finite-colin-machine/ME-507-GS425-Dashboard/docs/dash_installed.jpg

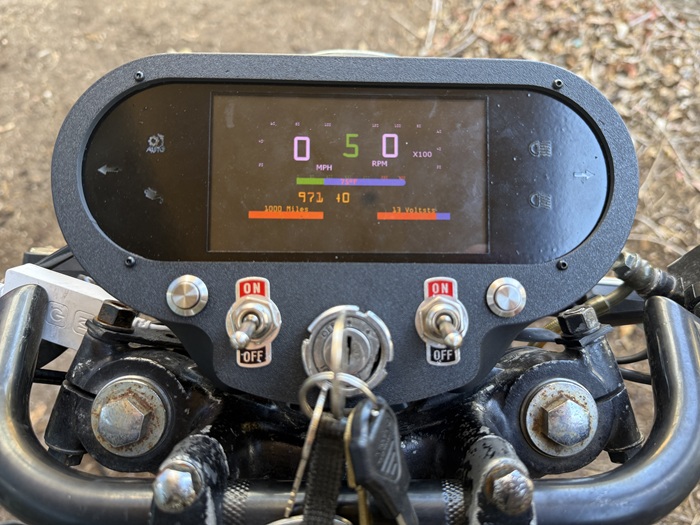
docs/dash_installed.jpg
