finite-colin-machine/ME-507-GS425-Dashboard/docs/dash_front.png

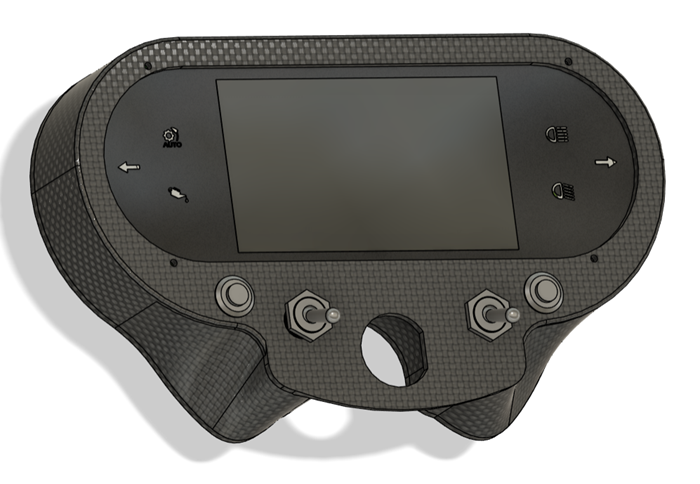
docs/dash_front.png
