finite-colin-machine/ME-507-GS425-Dashboard/docs/case_open.jpg

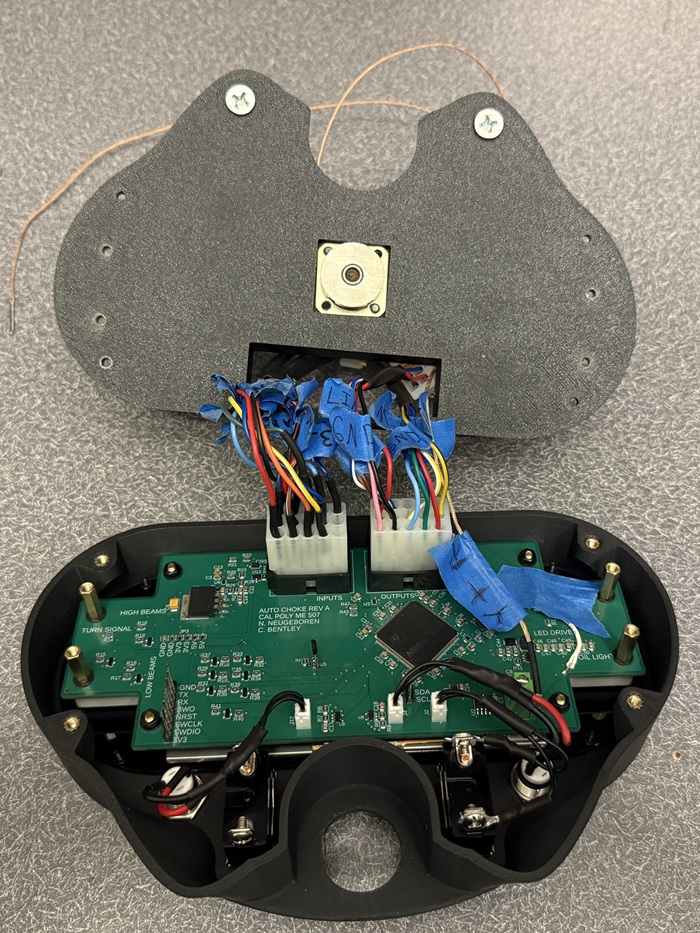
docs/case_open.jpg
