finite-colin-machine/ME-507-GS425-Dashboard/docs/choke_control_back.jpg

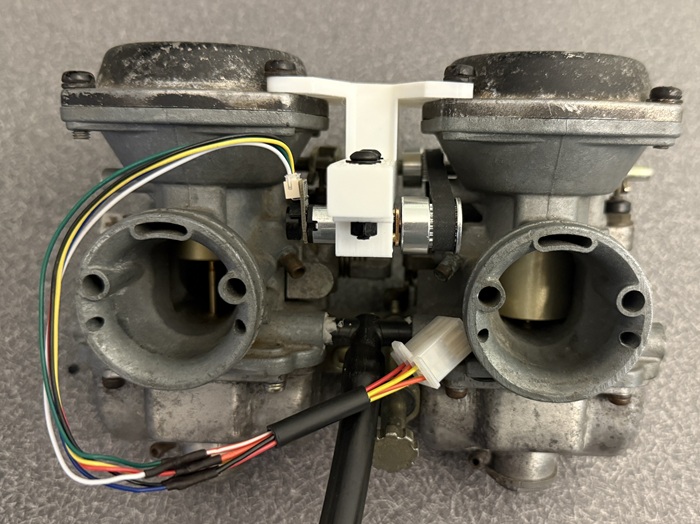
docs/choke_control_back.jpg
