finite-colin-machine/ME-507-GS425-Dashboard/docs/CIJV7845.JPG

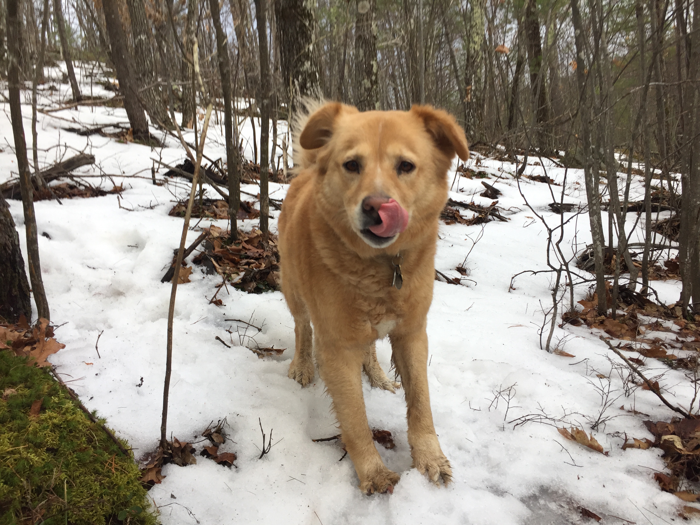
docs/CIJV7845.JPG
