finite-colin-machine/ME-507-GS425-Dashboard/docs/dash_back.png

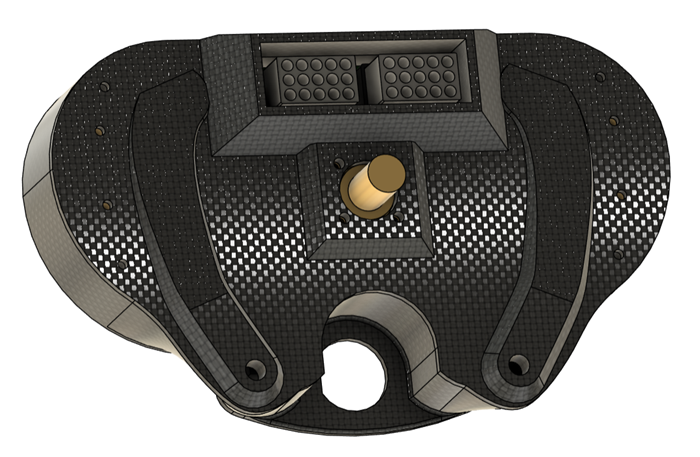
docs/dash_back.png
