finite-colin-machine/ME-507-GS425-Dashboard/docs/display.png

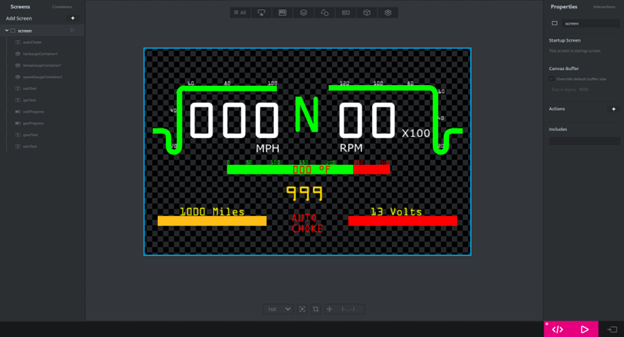
docs/display.png
