finite-colin-machine/ME-507-GS425-Dashboard/docs/DMA2D.png

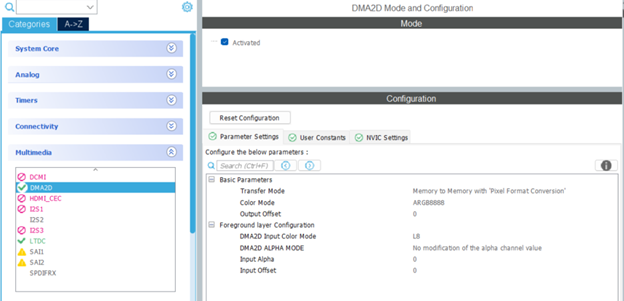
docs/DMA2D.png
