finite-colin-machine/ME-507-GS425-Dashboard/docs/electronics.png

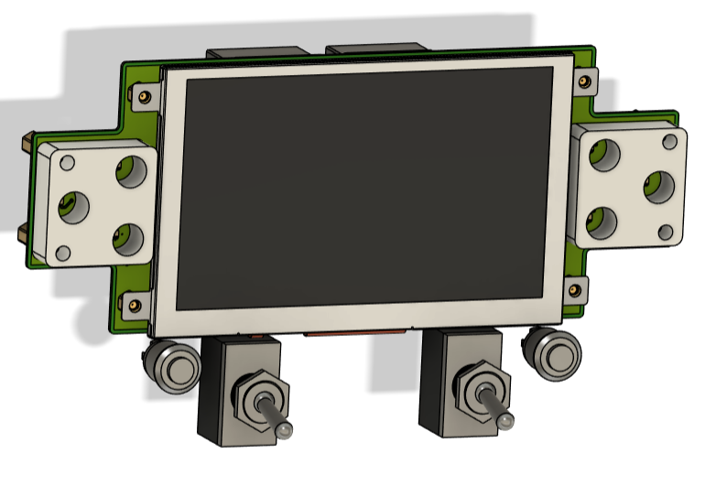
docs/electronics.png
