finite-colin-machine/ME-507-GS425-Dashboard/docs/LTDC.png

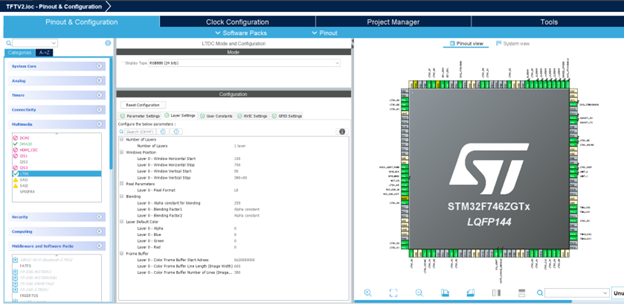
docs/LTDC.png
