finite-colin-machine/ME-507-GS425-Dashboard/docs/PCB.png

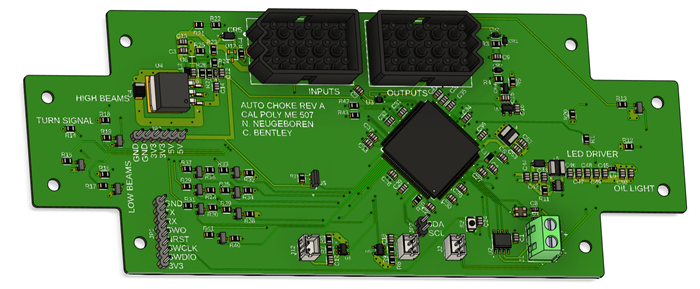
docs/PCB.png
