finite-colin-machine/ME-507-GS425-Dashboard/docs/task1.png

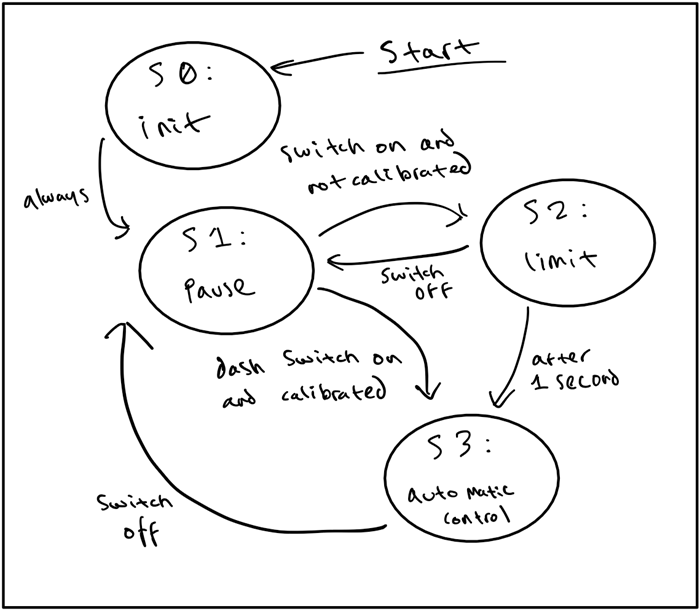
docs/task1.png
