finite-colin-machine/ME-507-GS425-Dashboard/docs/task2.png

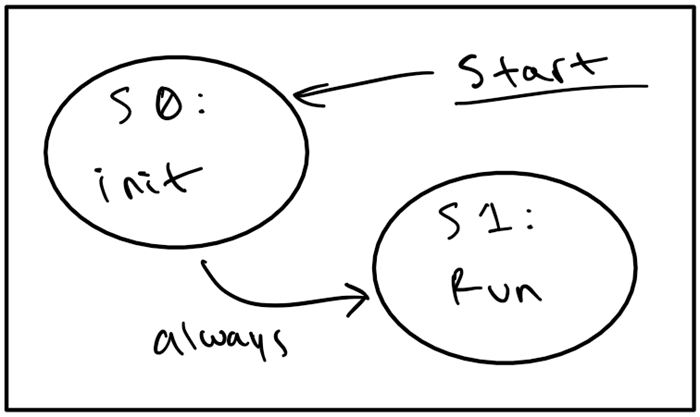
docs/task2.png
