finite-colin-machine/ME-507-GS425-Dashboard/hardware/Dashboard_BOM.xlsx

Description | Qty and/or Designator | Vendor | Vendor P/N
DC Motor with Encoder | 1 | Adafruit | 4641
Thermocouple | 1 | Adafruit | 3245
TFT Display | 1 | Riverdi | SM-RVT50HQTFWN00
40 Pin Connector | 1 | Riverdi | ZIF0540UH
Hall Effect Sensor | 1 | Digikey | 480-5925-ND
SWD Header | 1 | Digikey | 732-5321-ND
UI Switch | 2 | Digikey | CWI285-ND
UI Button | 2 | Digikey | 679-2452-ND
2 Pin Connector For Buttons and Switches | 3 | Digikey | 455-1704-ND
15 Pin Connector | 2 | Digikey | WM22700-ND
Limit Switches | 2 | Digikey | 39-SS-5GL2-ND
2 Position Screw Terminal | 1 | Digikey | A98076-ND
Red SMD LED | 1 | Digikey | 160-1427-1-ND
Blue SMD LED | 2 | Digikey | 160-1645-1-ND
Green SMD LED | 2 | Digikey | 160-1887-1-ND
Yellow SMD LED | 1 | Digikey | 160-1428-1-ND
100 nF | C1 C2 C10 C13 C16 C17 C18 C24 C25 C26 C27 C28 C29 C30 C31 C32 C33 C34 C35 C41 C43 C44 C45 C46 C51 C52 | JLCPCB | C28233
10 kohm | R2 R5 R6 R8 R10 R26 R42 R43 | JLCPCB | C17414
10 nF | C9 C47 C48 C49 C50 C53 | JLCPCB | C1710
1.5 ohm | R11 | JLCPCB | C17392
100 uF | C4 | JLCPCB | C7196
22 ohm | R12 R14 R16 R18 R28 R30 R32 R34 R36 R38 R40 | JLCPCB | C17561
5.6 kohm | R13 R15 R17 R19 R29 R31 R33 R35 R37 R39 R41 | JLCPCB | C4382
100 kohm | R44 | JLCPCB | C149504
10 pF | C11 | JLCPCB | C1634
10 uF | C3 C14 | JLCPCB | C15850
12 kohm | R21 | JLCPCB | C17444
15 pF | C7 C8 | JLCPCB | C1644
1 kohm | R3 | JLCPCB | C17513
1N4148 | CR1 CR2 CR3 | JLCPCB | C2128
2.2 uF | C5 C37 C39 | JLCPCB | C19110
220 kohm | R23 R27 | JLCPCB | C17556
22 uF | C12 | JLCPCB | C45783
3.3 kohm | R4 R7 R9 R22 | JLCPCB | C26010
30 kohm | R24 R25 | JLCPCB | C17621
4.7 uF | C6 C36 C42 | JLCPCB | C1779
4.7uH | L1 L2 | JLCPCB | C86090
47nF | C15 | JLCPCB | C53134
62 Ohm | R1 R20 | JLCPCB | C17784
S8050 | Q1 Q2 Q3 Q4 Q5 Q6 Q7 Q8 Q9 Q10 Q11 | JLCPCB | C2150
SN74LVC1G14DBVRDBV5 | U7 U8 U9 | JLCPCB | C7835
AO3401ASOT-23-3L_AOS | U12 | JLCPCB | C15127
B3U-X000B3U | S2 | JLCPCB | C231329
BLM18SG700TN1D | L6 | JLCPCB | C113031
SWPA4030S100MT | L5 L7 | JLCPCB | C38117
X322525MOB4SISMT | XTAL1 | JLCPCB | C9006
STM32F746ZGT6LQFP-144_STM | NC | JLCPCB | C90750
DIO5661ST6 | U10 | JLCPCB | C324576
DRV8210DRLRSOT_210DRLR_TEX | U3 | JLCPCB | C3681297
MAX6675ISA_T | U2 | JLCPCB | C16030
LBZT52C8V2T1G | CR5 | JLCPCB | C12747
LM1085ISX-3.3/NOPBKTT3 | U4 | JLCPCB | C19545
MCR100 | CR4 | JLCPCB | C5184415
SS26FL | U11 | JLCPCB | C183996
TPS564257DRLR_TEX | U6 | JLCPCB | C19272233
