finite-colin-machine/ME-507-GS425-Dashboard/hardware/Auto_Choke_CAD.STEP

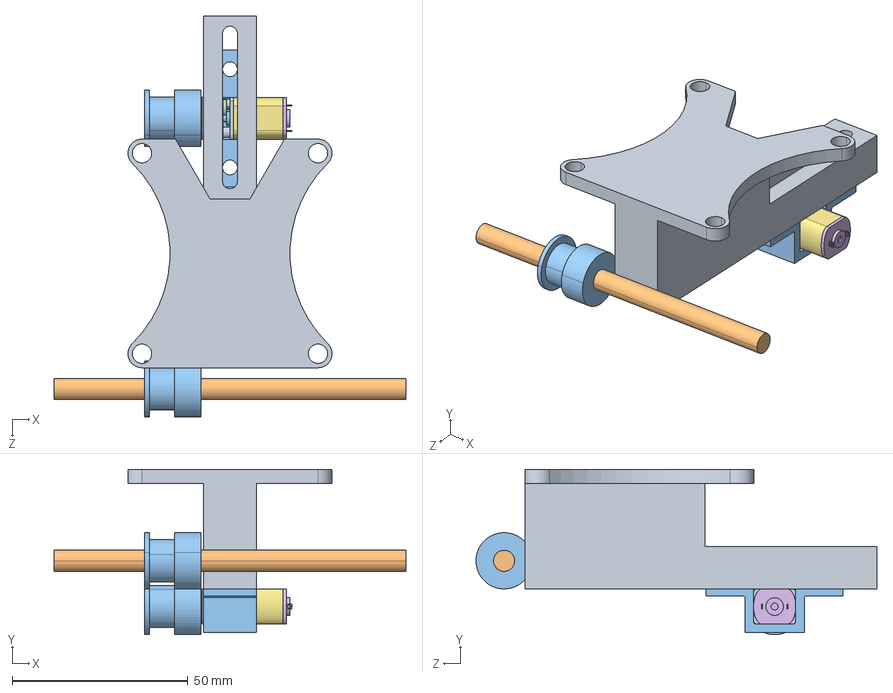
[picture p15: CAD file, 2025-06-11]
hardware/Auto_Choke_CAD.STEP
100.0 x 47.0 x 114.0 mm
carb_plate
carb_shaft
pulleygear x 2
N20 Motor
motor_mount
