finite-colin-machine/ME-507-GS425-Dashboard/hardware/GS425_Dashboard_Wiring.pdf

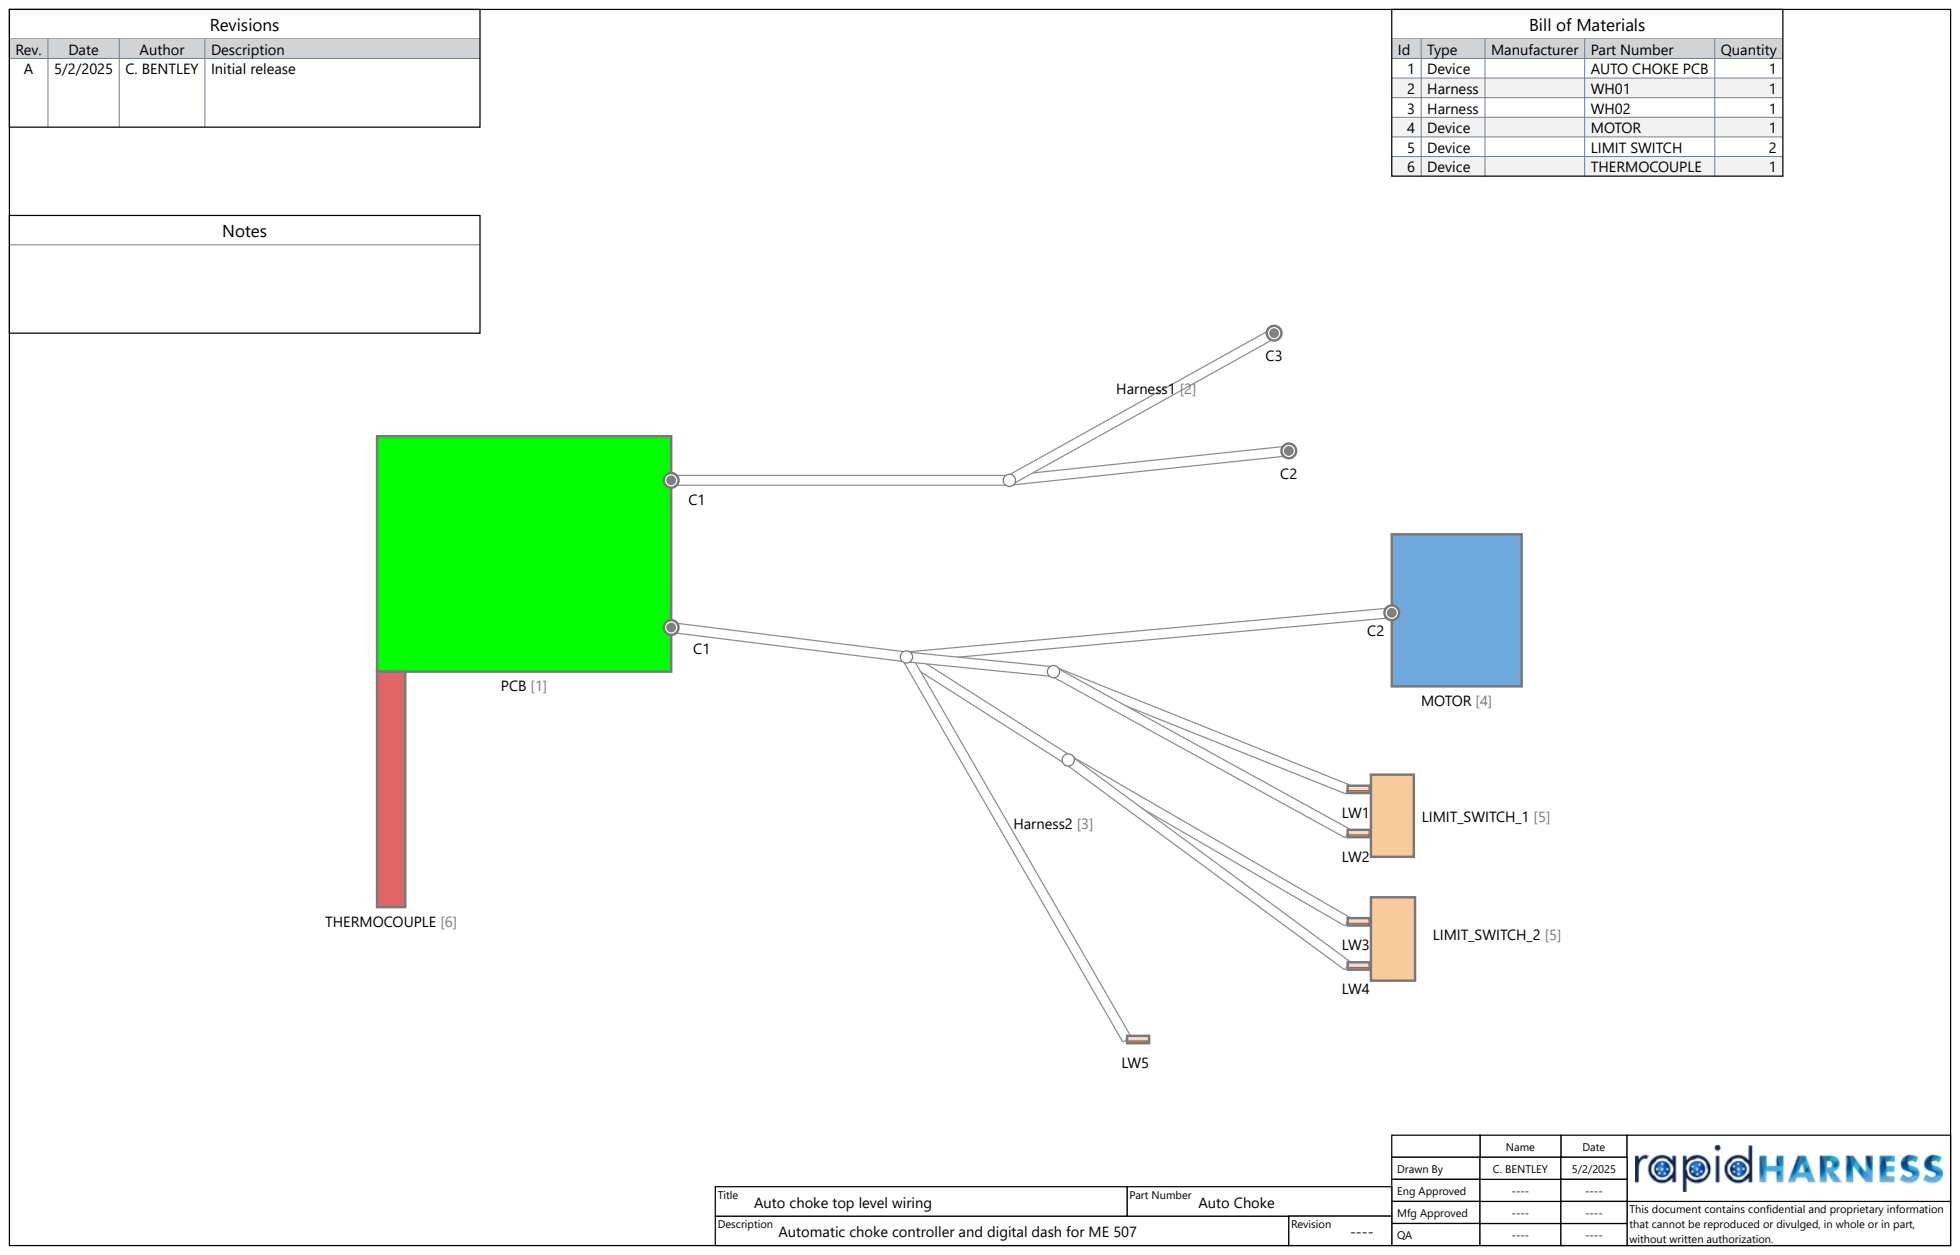
[picture p16: page 1]
Description; Name; Date; Drawn By; Eng Approved; Mfg Approved; Part Number; Revision; Auto Choke; Automatic choke controller and digital dash for ME 507; C. BENTLEY; Type; Manufacturer; Quantity; Device; AUTO CHOKE PCB; Harness; MOTOR; LIMIT SWITCH; THERMOCOUPLE; Notes; Revisions; Rev.; Author; Initial release; PCB [1]; MOTOR [4]; LIMIT_SWITCH_1 [5]; LIMIT_SWITCH_2 [5]; THERMOCOUPLE [6]; Harness1 [2]; Harness2 [3]

Bill of Materials

Title
Auto choke top level wiring

This document contains confidential and proprietary information
that cannot be reproduced or divulged, in whole or in part,
without written authorization.

Rev. | Date | Author | Description
A | 5/2/2025 | C. BENTLEY | Initial release
Revisions 1 of 1 | Page 2 of 7

Title:

Part Number: | Auto Choke
Description: | Automatic choke controller and digital dash for ME 507

Flag | Quantity | Note
Notes 1 of 1 | Page 3 of 7
| Auto Choke
Description: | Automatic choke controller and digital dash for ME 507

Id | Type | Manufacturer | Part Number | Description | Quantity | Usage
1 | Device | AUTO CHOKE PCB | 1 | PCB
2 | Harness | WH01 | Connects PCB to existing bike connections | 1 | Harness1
3 | Harness | WH02 | Connects PCB to new devices on bike | 1 | Harness2
4 | Device | MOTOR | 1 | MOTOR
5 | Device | LIMIT SWITCH | 2 | LIMIT_SWITCH_1, LIMIT_SWITCH_2
6 | Device | THERMOCOUPLE | 1 | THERMOCOUPLE
Bill of Materials 1 of 1 | Page 4 of 7

Description:

Auto Choke

Automatic choke controller and digital dash for ME 507

# | Type | Manufacturer | Part Number | Description | Quantity

2 | Connector | MOLEX | 03091157 | 2.36mm Diameter Standard .093" Pin and Socket Receptacle Housing, 15 Circuits, 3 Rows, without Mounting Ears, with Lock Ramps | 2
6 | Connector | MOLEX | 0510210600 | CONN RCPT HSG 6POS 1.25MM | 1
3 | Connector | Ruibapa | P-029-06 | 2.8mm automotive wire connector | 1
4 | Connector | Ruibapa | P-029-08 | 2.8mm automotive wire connector | 1
1 | Device | | AUTO CHOKE PCB | | 1
8 | Device | | LIMIT SWITCH | | 2
7 | Device | | MOTOR | | 1
9 | Device | | THERMOCOUPLE | | 1
5 | Wire | | | | 0 in
Aggregate Bom 1 of 1 | Page 5 of 7
| Auto Choke
Description: | Automatic choke controller and digital dash for ME 507

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
al 1 | Harness1 Harness1 | C1.1 C2.1 2 | Harness1 Harness1 | C1.2 C2.2 3 | Harness1 Harness1 | C1.3 C2.3 4 | Harness1 Harness1 | C1.4 C2.4 5 | Harness1 Harness1 | C1.5 C2.5 6 | Harness1 Harness1 | C1.6 C2.6 7 | Harness1 Harness1 | C1.7 C3.1 8 | Harness1 Harness1 | C1.8 C3.2 9 | Harness1 Harness1 | C1.9 C3.3
1 0 | H a r n e s s 1 H a r n e s s 1 | C 1 . 1 0 C 3 . 4
1 1 | H a r n e s s 1 H a r n e s s 1 | C 1 . 1 1 C 3 . 5
1 2 | H a r n e s s 1 H a r n e s s 1 | C 1 . 1 2 C 3 . 6
1 3 | H a r n e s s 1 H a r n e s s 1 | C 1 . 1 3 C 3 . 7
1 4 | H a r n e s s 2 H a r n e s s 2 | C 1 . 1 C 2 . 1
1 5 | H a r n e s s 2 H a r n e s s 2 | C 1 . 2 C 2 . 2
1 6 | H a r n e s s 2 H a r n e s s 2 | C 1 . 3 C 2 . 3
1 7 | H a r n e s s 2 H a r n e s s 2 | C 1 . 4 C 2 . 4
1 8 | H a r n e s s 2 H a r n e s s 2 | C 1 . 5 C 2 . 5
1 9 | H a r n e s s 2 H a r n e s s 2 | C 1 . 6 C 2 . 6
2 0 | H a r n e s s 2 H a r n e s s 2 | C 1 . 7 LW 1
2 1 | H a r n e s s 2 | C 1 . 8

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

# | Subsystem | Device / Harness | Endpoint | Signal

| | Harness2 | LW2
22 | | Harness2 Harness2 | C1.9 LW3
23 | | Harness2 Harness2 | C1.10 LW4
24 | | Harness2 Harness2 | C1.11 LW5
Nets 2 of 2 | Page 7 of 7
| Auto Choke
Description: | Automatic choke controller and digital dash for ME 507

Description

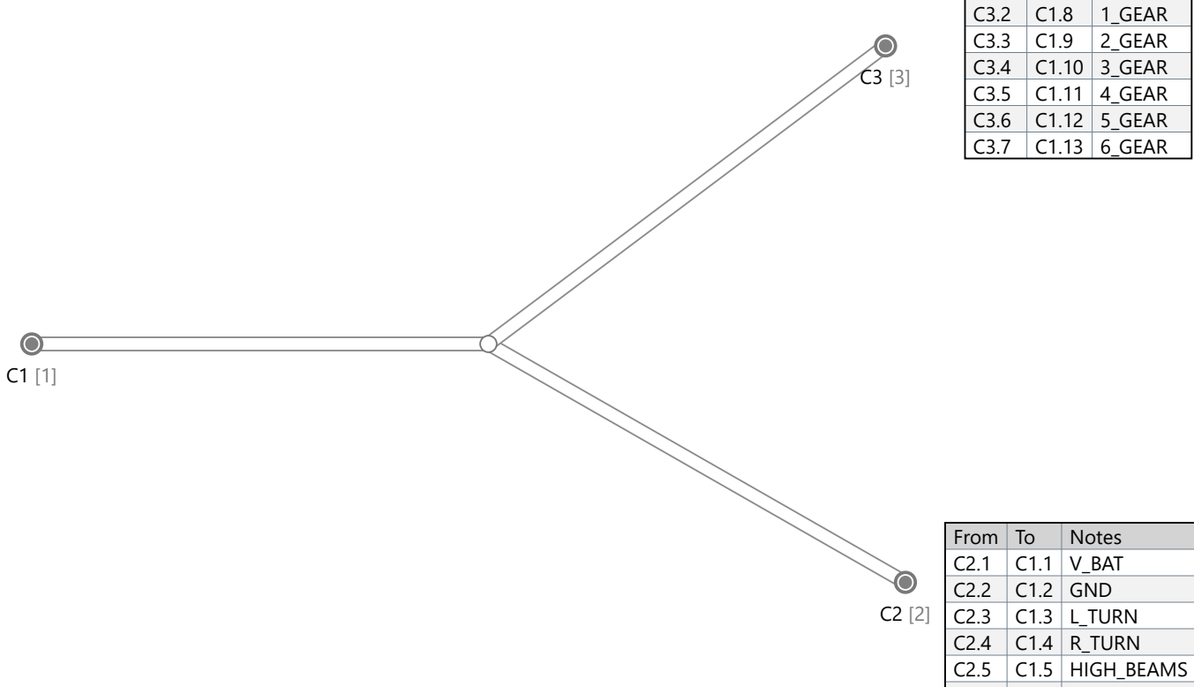
[picture p17: figure]
From; Notes; V_BAT; GND; L_TURN; R_TURN; HIGH_BEAMS; 1_GEAR; 2_GEAR; 3_GEAR; 4_GEAR; 5_GEAR; 6_GEAR

Name | Date

Drawn By

Eng Approved

Mfg Approved

QA

This document contains confidential and proprietary information that cannot be reproduced or divulged, in whole or in part, without written authorization.

Part Number

Revision

Title | WH01
Connects PCB to existing bike connections | ----
C. BENTLEY | 5/2/2025

Existing Harness

Bill of Materials

Id | Type | Manufacturer | Part Number | Quantity
1 | Connector | MOLEX | 03091157 | 1
2 | Connector | Ruibapa | P-029-06 | 1
3 | Connector | Ruibapa | P-029-08 | 1
4 | Wire | | | 0 in

Notes

Revisions

Rev. | Date | Author | Description
A | 5/2/2025 | C. BENTLEY | Initial release
From | To | Notes
C1.1 | C2.1 | V_BAT
C1.2 | C2.2 | GND
C1.3 | C2.3 | L_TURN
C1.4 | C2.4 | R_TURN
C1.5 | C2.5 | HIGH_BEAMS
C1.6 | C2.6 | LOW_BEAMS
C1.7 | C3.1 | NEUTRAL
C1.8 | C3.2 | 1_GEAR
C1.9 | C3.3 | 2_GEAR
C1.10 | C3.4 | 3_GEAR
C1.11 | C3.5 | 4_GEAR
C1.12 | C3.6 | 5_GEAR
C1.13 | C3.7 | 6_GEAR
C2.6 | C1.6 | LOW_BEAMS
From | To | Notes
C3.1 | C1.7 | NEUTRAL

Rev. | Date | Author | Description
A | 5/2/2025 | C. BENTLEY | Initial release
Revisions 1 of 1 | Page 2 of 7
| WH01
Description: | Connects PCB to existing bike connections

Flag | Quantity | Note
Notes 1 of 1 | Page 3 of 7

Description:

Connects PCB to existing bike connections

Id | Type | Manufacturer | Part Number | Description | Quantity | Usage
1 | Connector | MOLEX | 03091157 | 2.36mm Diameter Standard .093" Pin and Socket
| | | | Receptacle Housing, 15 Circuits, 3 Rows, without Mounting Ears, with Lock Ramps
1 | C1
2 | Connector | Ruibapa | P-029-06 | 2.8mm automotive wire connector | 1 | C2
3 | Connector | Ruibapa | P-029-08 | 2.8mm automotive wire connector | 1 | C3
4 | Wire | | | | 0 in | W1
Bill of Materials 1 of 1 | Page 4 of 7

Description:

Connects PCB to existing bike connections

From | To | Conductor | Conductor PN | Twisted With | Size | Length | From Contact PN | Notes
C1.1 | C2.1 | | | | | | | V_BAT
C1.2 | C2.2 | | | | | | | GND
C1.3 | C2.3 | | | | | | | L_TURN
C1.4 | C2.4 | | | | | | | R_TURN
C1.5 | C2.5 | | | | | | | HIGH_BEAMS
C1.6 | C2.6 | | | | | | | LOW_BEAMS
C1.7 | C3.1 | | | | | | | NEUTRAL
C1.8 | C3.2 | | | | | | | 1_GEAR
C1.9 | C3.3 | | | | | | | 2_GEAR
C1.10 | C3.4 | | | | | | | 3_GEAR
C1.11 | C3.5 | | | | | | | 4_GEAR
C1.12 | C3.6 | | | | | | | 5_GEAR
C1.13 | C3.7 | | | | | | | 6_GEAR
Wiring Table 1 of 1 | Page 5 of 7

Description:

Connects PCB to existing bike connections

# | Type | Reference Designator | Manufacturer | Part Number | Color | Size | From Strip | To Strip | Length | Twisted With | Notes

1 | C1.1 - C2.1 | V_BAT
2 | C1.2 - C2.2 | GND
3 | C1.3 - C2.3 | L_TURN
4 | C1.4 - C2.4 | R_TURN
5 | C1.5 - C2.5 | HIGH_BEAMS
6 | C1.6 - C2.6 | LOW_BEAMS
7 | C1.7 - C3.1 | NEUTRAL
8 | C1.8 - C3.2 | 1_GEAR
9 | C1.9 - C3.3 | 2_GEAR
10 | C1.10 - C3.4 | 3_GEAR
11 | C1.11 - C3.5 | 4_GEAR
12 | C1.12 - C3.6 | 5_GEAR
13 | C1.13 - C3.7 | 6_GEAR
Cutlist 1 of 1 | Page 6 of 7

Description:

Connects PCB to existing bike connections

# | Manufacturer | Part Number | Description | Label Text

Labels 1 of 1 | Page 7 of 7

Description:

Connects PCB to existing bike connections

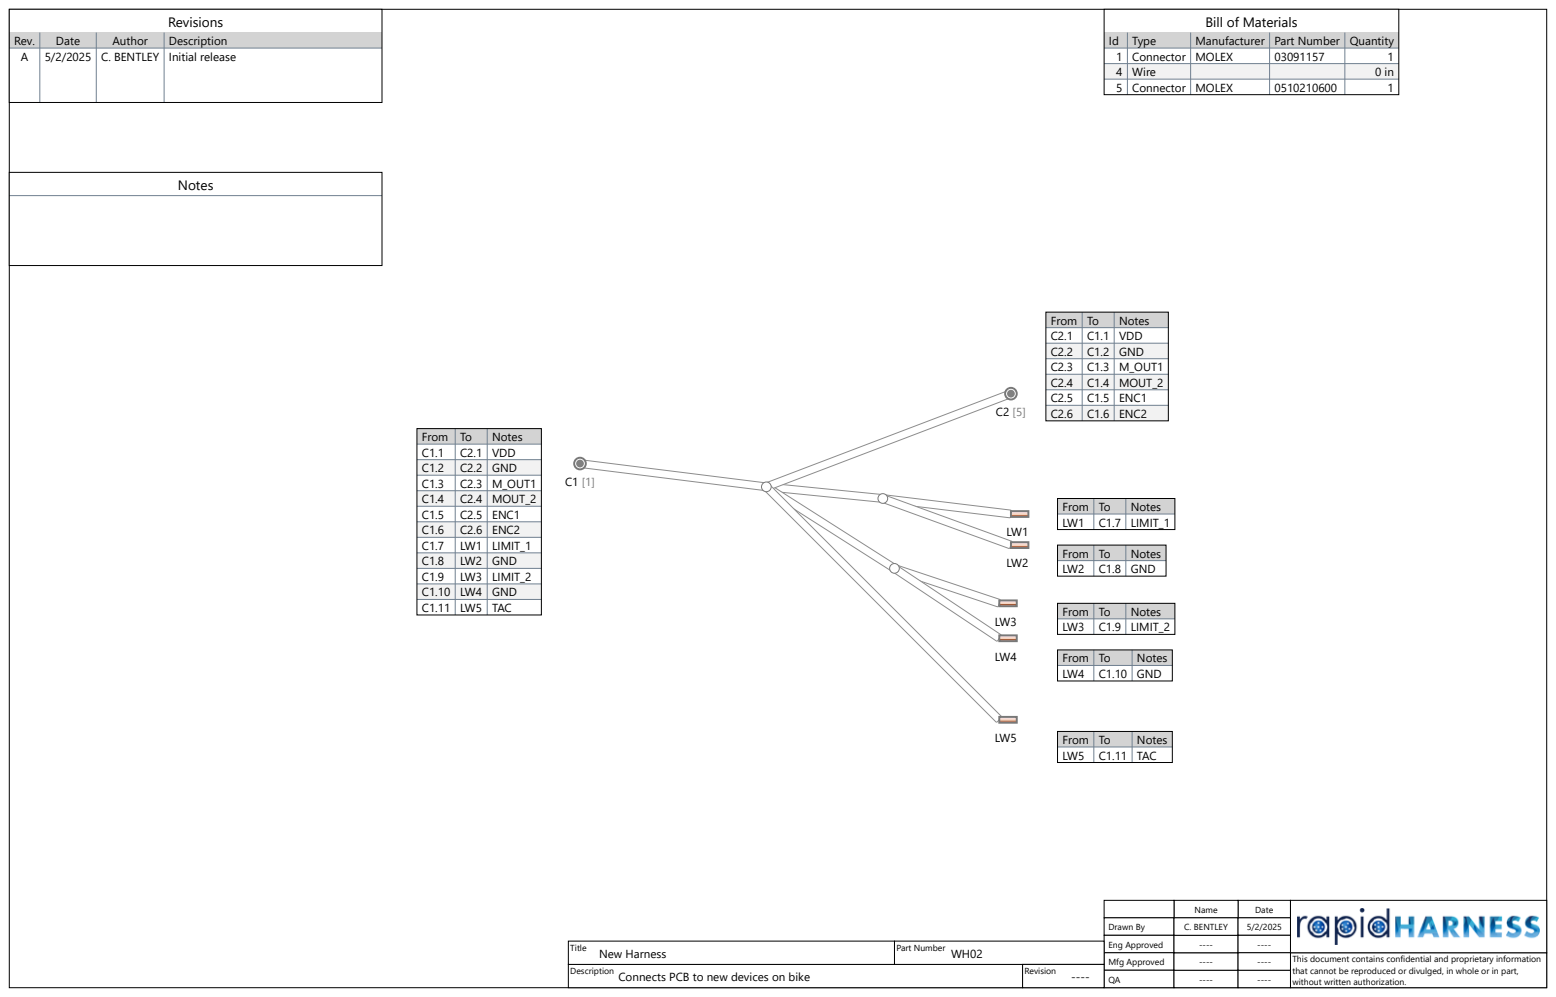
[picture p18: page 15]
Description; Name; Date; Drawn By; Eng Approved; Mfg Approved; Part Number; Revision; Title; Connects PCB to new devices on bike; C. BENTLEY; New Harness; Type; Manufacturer; Quantity; Connector; MOLEX; Wire; Notes; Revisions; Rev.; Author; Initial release; From; VDD; GND; M_OUT1; MOUT_2; ENC1; ENC2; LIMIT_1; LIMIT_2; TAC

Bill of Materials

This document contains confidential and proprietary information
that cannot be reproduced or divulged, in whole or in part,
without written authorization.

Rev. | Date | Author | Description
A | 5/2/2025 | C. BENTLEY | Initial release
Revisions 1 of 1 | Page 2 of 7

Description:

Connects PCB to new devices on bike

Flag | Quantity | Note
Notes 1 of 1 | Page 3 of 7

Description:

Connects PCB to new devices on bike

Id | Type | Manufacturer | Part Number | Description | Quantity | Usage
1 | Connector | MOLEX | 03091157 | 2.36mm Diameter Standard .093" Pin and Socket
| | | | Receptacle Housing, 15 Circuits, 3 Rows, without Mounting Ears, with Lock Ramps
1 | C1
4 | Wire | | | | 0 in | W1
5 | Connector | MOLEX | 0510210600 | CONN RCPT HSG 6POS 1.25MM | 1 | C2
Bill of Materials 1 of 1 | Page 4 of 7

Description:

Connects PCB to new devices on bike

From | To | Conductor | Conductor PN | Twisted With | Size | Length | From Contact PN | Notes
C1.1 | C2.1 | | | | | | | VDD
C1.2 | C2.2 | | | | | | | GND
C1.3 | C2.3 | | | | | | | M_OUT1
C1.4 | C2.4 | | | | | | | MOUT_2
C1.5 | C2.5 | | | | | | | ENC1
C1.6 | C2.6 | | | | | | | ENC2
C1.7 | LW1 | | | | | | | LIMIT_1
C1.8 | LW2 | | | | | | | GND
C1.9 | LW3 | | | | | | | LIMIT_2
C1.10 | LW4 | | | | | | | GND
C1.11 | LW5 | | | | | | | TAC
Wiring Table 1 of 1 | Page 5 of 7

Description:

Connects PCB to new devices on bike

# | Type | Reference Designator | Manufacturer | Part Number | Color | Size | From Strip | To Strip | Length | Twisted With | Notes

1 | C1.1 - C2.1 | VDD
2 | C1.2 - C2.2 | GND
3 | C1.3 - C2.3 | M_OUT1
4 | C1.4 - C2.4 | MOUT_2
5 | C1.5 - C2.5 | ENC1
6 | C1.6 - C2.6 | ENC2
7 | C1.7 - LW1 | LIMIT_1
8 | C1.8 - LW2 | GND
9 | C1.9 - LW3 | LIMIT_2
10 | C1.10 - LW4 | GND
11 | C1.11 - LW5 | TAC
Cutlist 1 of 1 | Page 6 of 7

Description:

Connects PCB to new devices on bike

# | Manufacturer | Part Number | Description | Label Text

Labels 1 of 1 | Page 7 of 7

Description:

Connects PCB to new devices on bike
