finite-colin-machine/ME-507-GS425-Dashboard/software/Core/Inc/main.h

#define BACK_LIGHT_PWM_Pin GPIO_PIN_6
#define BACK_LIGHT_PWM_GPIO_Port GPIOF
#define NOT_CS_Pin GPIO_PIN_9
#define NOT_CS_GPIO_Port GPIOF
#define OIL_LIGHT_Pin GPIO_PIN_0
#define OIL_LIGHT_GPIO_Port GPIOG
#define AUTO_CHOKE_ENABLE_Pin GPIO_PIN_1
#define AUTO_CHOKE_ENABLE_GPIO_Port GPIOG
#define LIMIT_1_Pin GPIO_PIN_4
#define LIMIT_1_GPIO_Port GPIOG
#define LIMIT_2_Pin GPIO_PIN_5
#define LIMIT_2_GPIO_Port GPIOG
#define LTDC_DISP_Pin GPIO_PIN_6
#define LTDC_DISP_GPIO_Port GPIOG
#define WHEEL_SPEED_Pin GPIO_PIN_15
#define WHEEL_SPEED_GPIO_Port GPIOA
#define _1_GEAR_Pin GPIO_PIN_10
#define _1_GEAR_GPIO_Port GPIOC
#define _2_GEAR_Pin GPIO_PIN_11
#define _2_GEAR_GPIO_Port GPIOC
#define _3_GEAR_Pin GPIO_PIN_12
#define _3_GEAR_GPIO_Port GPIOC
#define _4_GEAR_Pin GPIO_PIN_0
#define _4_GEAR_GPIO_Port GPIOD
#define _5_GEAR_Pin GPIO_PIN_1
#define _5_GEAR_GPIO_Port GPIOD
#define _6_GEAR_Pin GPIO_PIN_2
#define _6_GEAR_GPIO_Port GPIOD
#define N_GEAR_Pin GPIO_PIN_4
#define N_GEAR_GPIO_Port GPIOD
