finite-colin-machine/ME-507-GS425-Dashboard/(commit log)

2025-06-11 Uploading electronics and hardware design
    [Auto_Choke_CAD.STEP]
2025-06-11 add wiring diagram
2025-06-11 Add BOM
    [dashboard_BOM.xlsx]
