finite-colin-machine/ME-507-GS425-Dashboard/(notices)

Notices in the files:
software/Core/Src/main.cpp:
Copyright (c) 2025 STMicroelectronics.
All rights reserved.
This software is licensed under terms that can be found in the LICENSE file
